laxmesh22/medha/hardware/renders/unit_waist_exploded.png

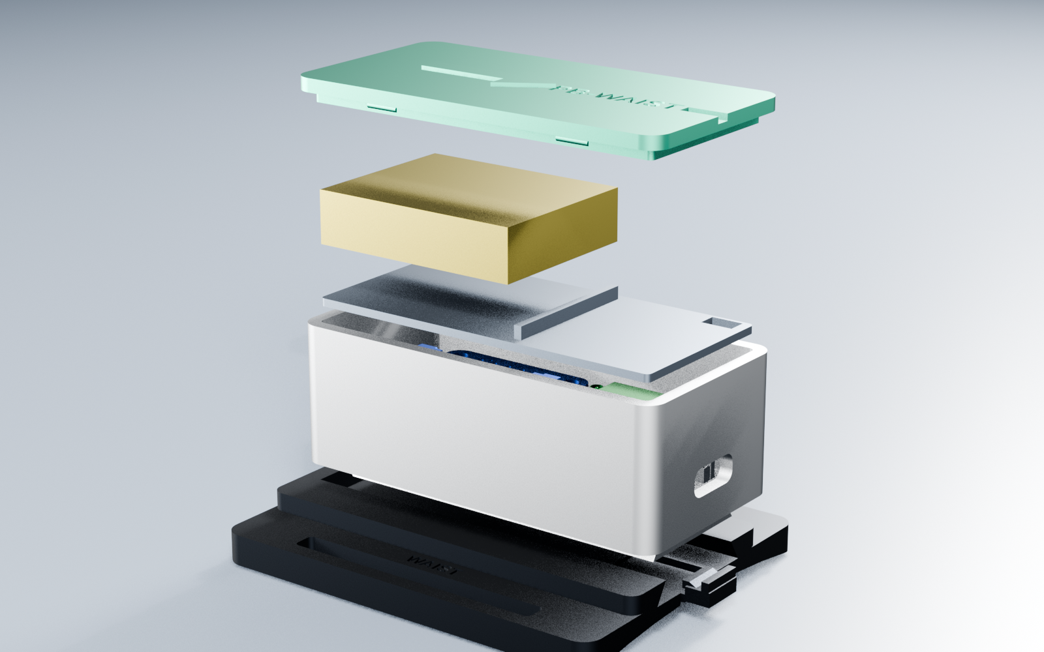
hardware/renders/unit_waist_exploded.png
