laxmesh22/medha/hardware/renders/unit_forearm_hero.png

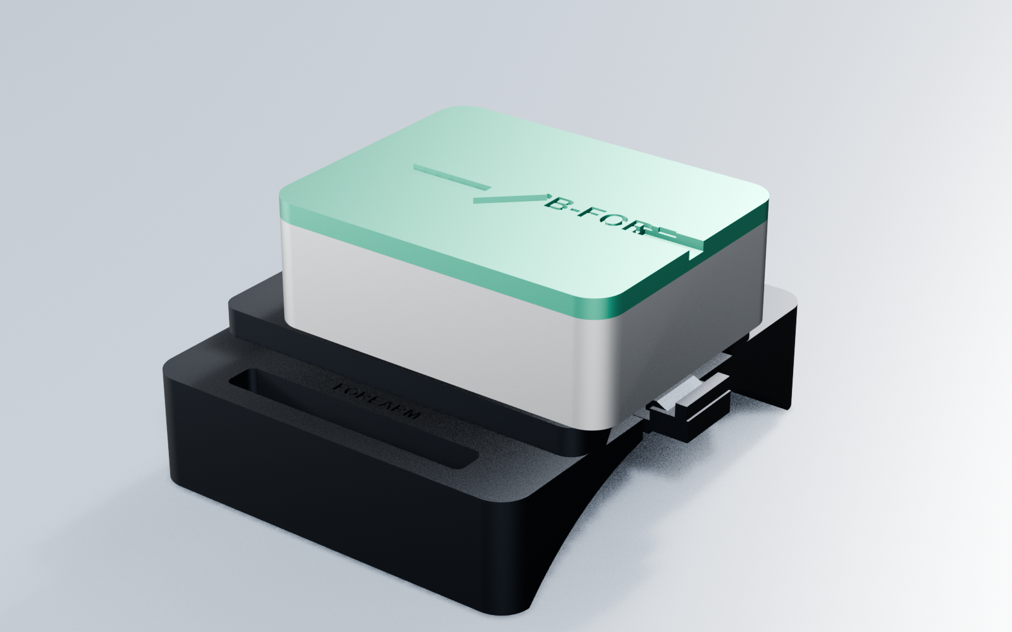
hardware/renders/unit_forearm_hero.png
