laxmesh22/medha/hardware/renders/frames_sheet.jpg

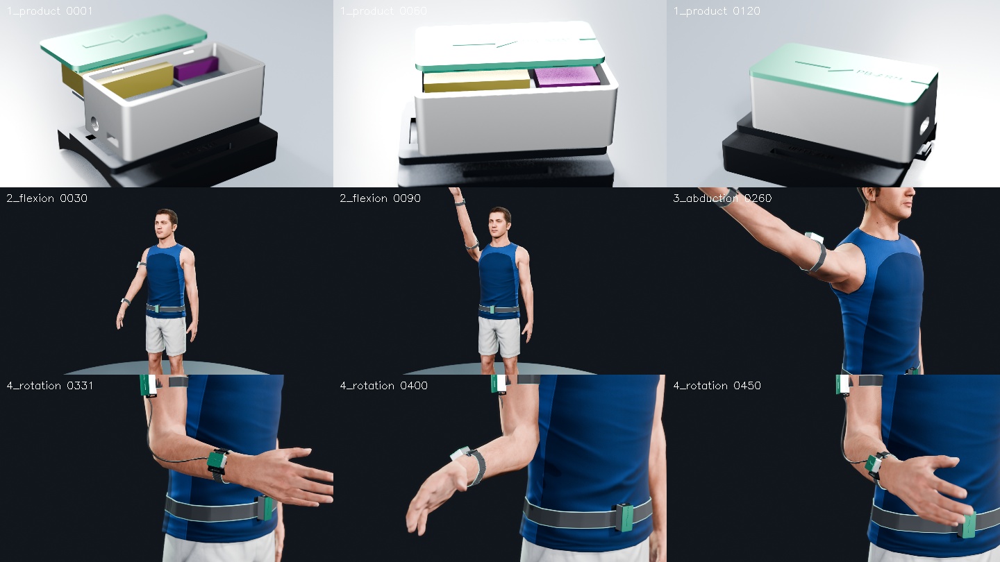
hardware/renders/frames_sheet.jpg
