laxmesh22/medha/hardware/renders/unit_chest_hero.png

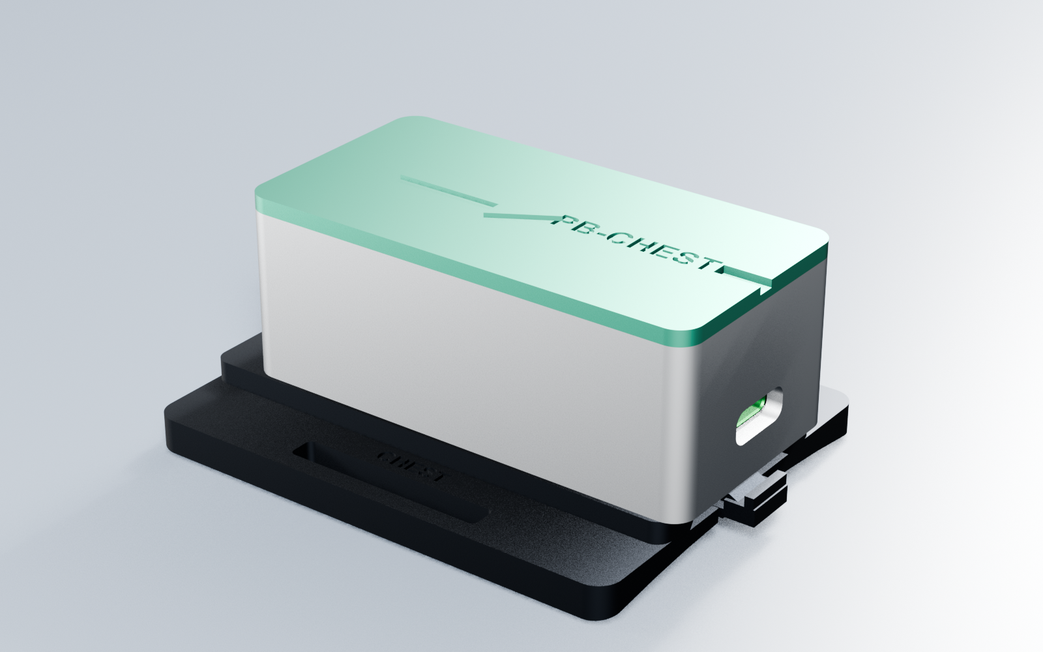
hardware/renders/unit_chest_hero.png
