laxmesh22/medha/hardware/renders/unit_forearm_exploded.png

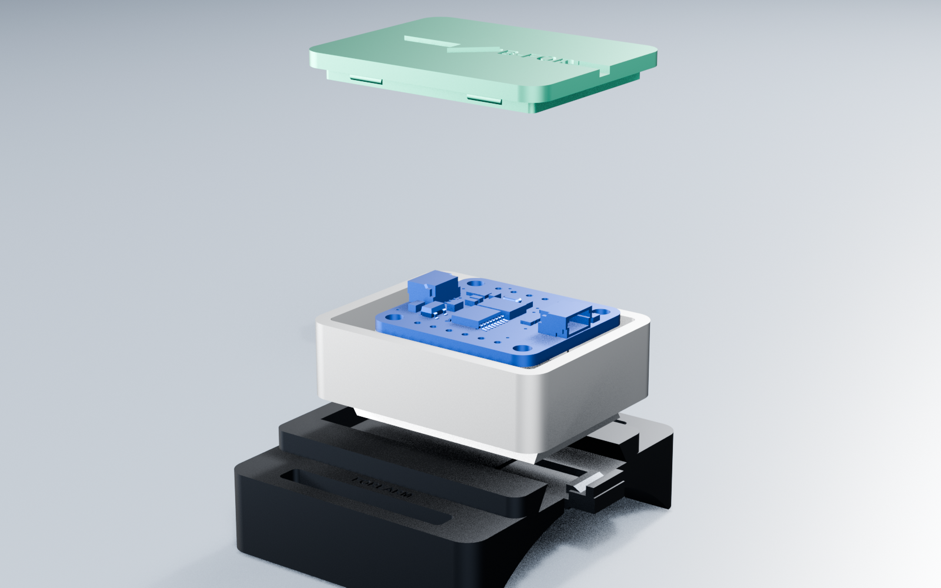
hardware/renders/unit_forearm_exploded.png
