laxmesh22/medha/hardware/renders/unit_upperarm_exploded.png

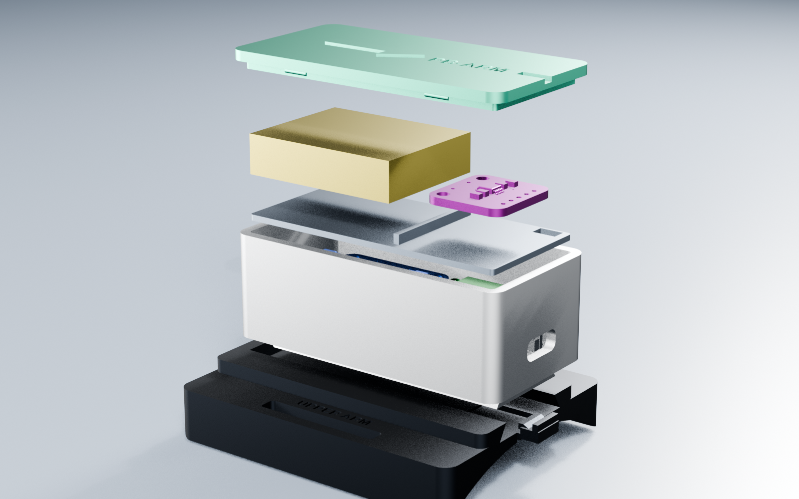
hardware/renders/unit_upperarm_exploded.png
