laxmesh22/medha/hardware/renders/unit_upperarm_hero.png

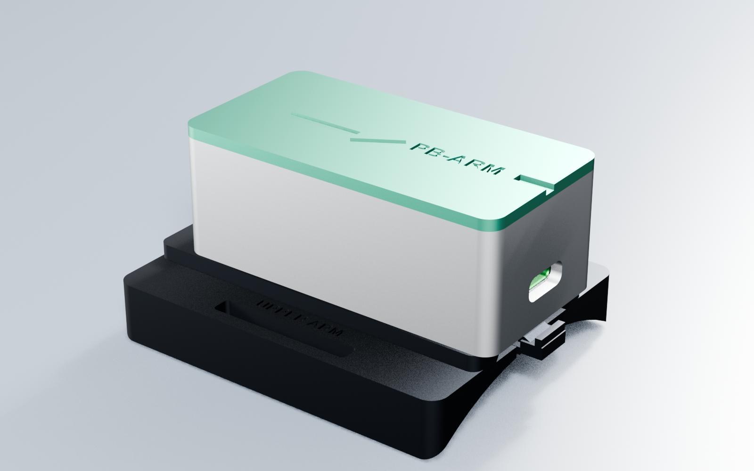
hardware/renders/unit_upperarm_hero.png
