laxmesh22/medha/hardware/cad/out/step/unit_upperarm.step

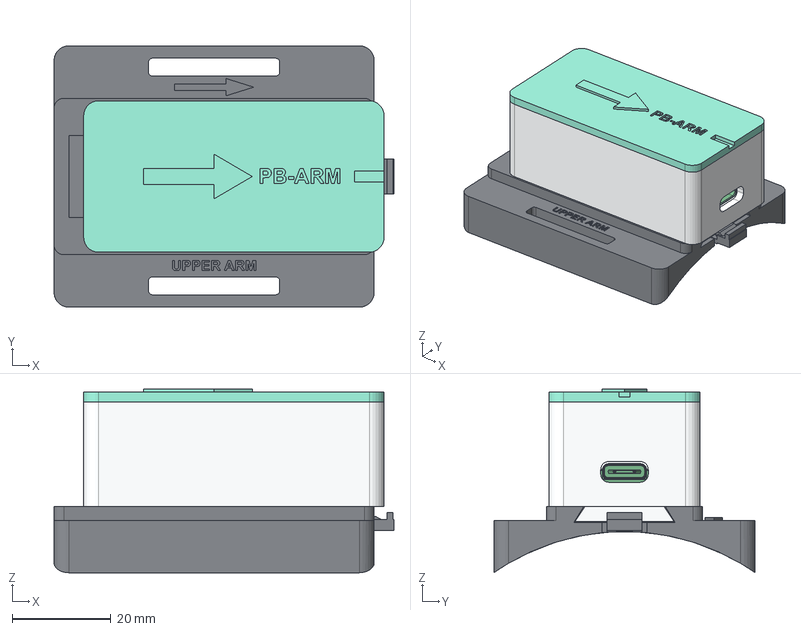
[picture p8: CAD file, 2026-10-26]
hardware/cad/out/step/unit_upperarm.step
68.7 x 52.8 x 37.1 mm
base
deck
lid
bno085
xiao
motor
switch
lipo
drv2605
