laxmesh22/medha/hardware/cad/out/step/base_forearm.step

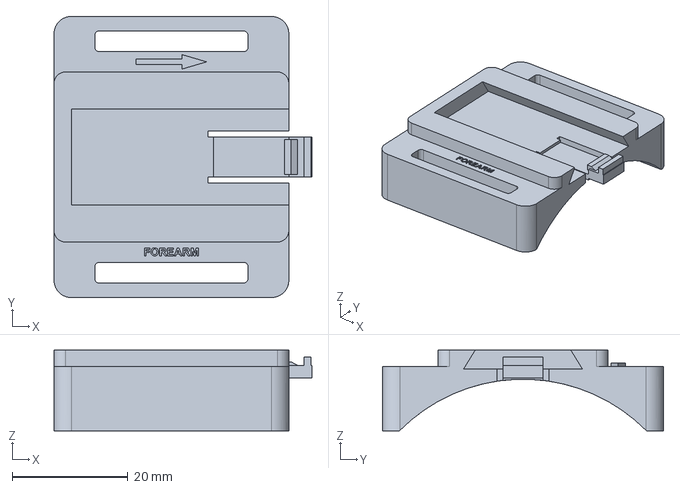
[picture p9: CAD file, 2026-10-26]
hardware/cad/out/step/base_forearm.step
44.6 x 48.6 x 14.0 mm
