laxmesh22/medha/hardware/cad/out/step/pod_arm_deck.step

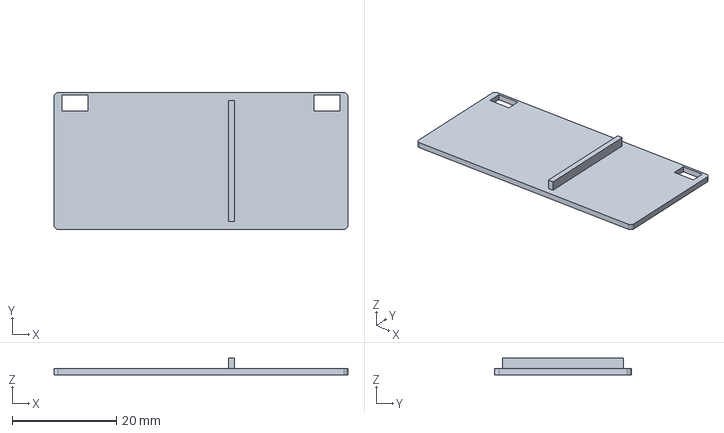
[picture p10: CAD file, 2026-10-26]
hardware/cad/out/step/pod_arm_deck.step
56.3 x 26.2 x 3.20 mm
