laxmesh22/medha/hardware/cad/out/step/pod_forearm_lid.step

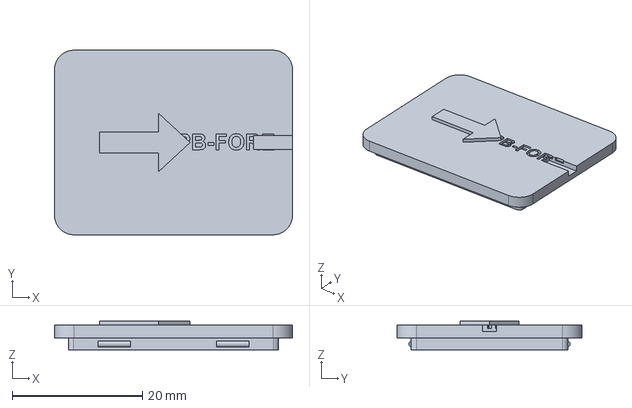
[picture p11: CAD file, 2026-10-26]
hardware/cad/out/step/pod_forearm_lid.step
36.6 x 28.4 x 4.40 mm
