laxmesh22/medha/hardware/cad/out/step/base_waist.step

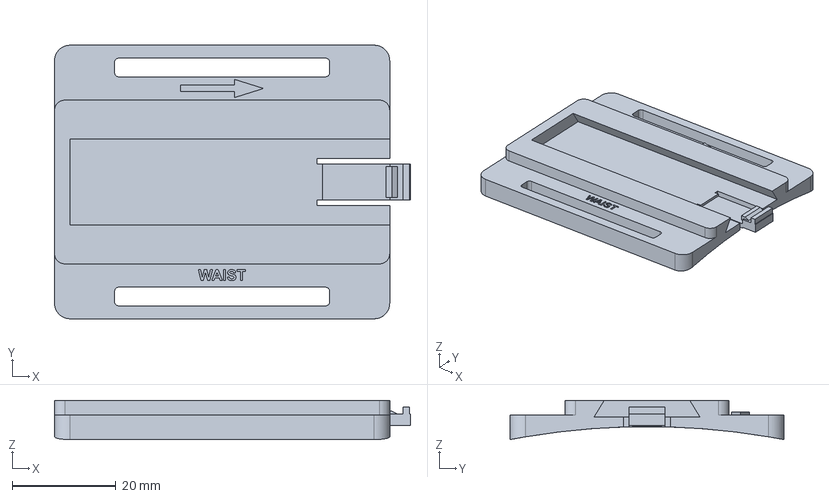
[picture p12: CAD file, 2026-10-26]
hardware/cad/out/step/base_waist.step
68.7 x 52.8 x 7.56 mm
