laxmesh22/medha/hardware/cad/out/step/base_upperarm.step

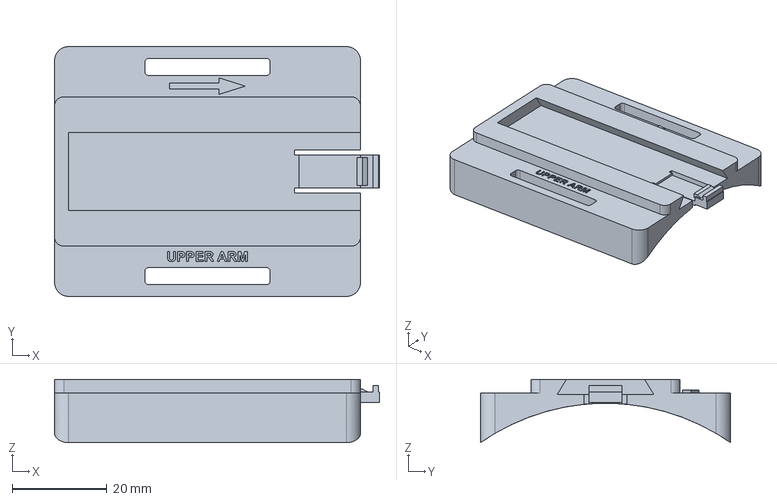
[picture p13: CAD file, 2026-10-26]
hardware/cad/out/step/base_upperarm.step
68.7 x 52.8 x 13.4 mm
