laxmesh22/medha/hardware/cad/out/step/pod_arm_body.step

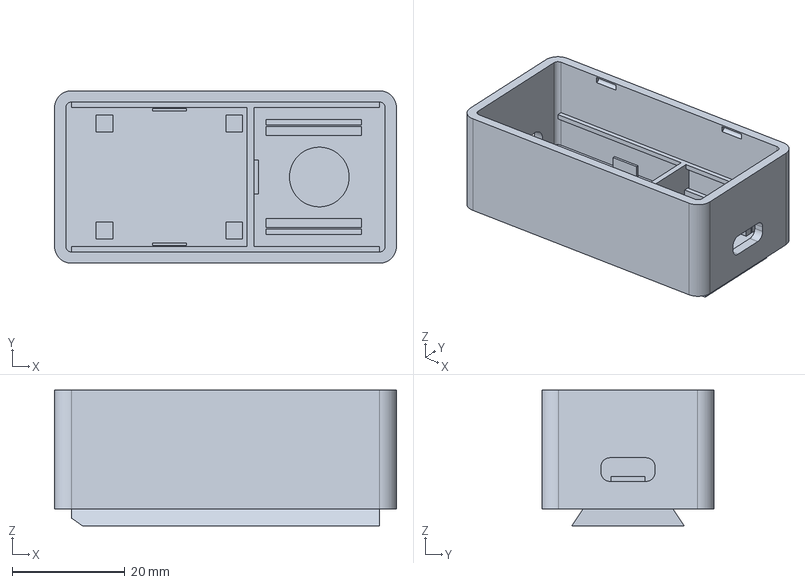
[picture p14: CAD file, 2026-10-26]
hardware/cad/out/step/pod_arm_body.step
60.7 x 30.6 x 24.1 mm
