laxmesh22/medha/hardware/cad/out/step/pod_waist_lid.step

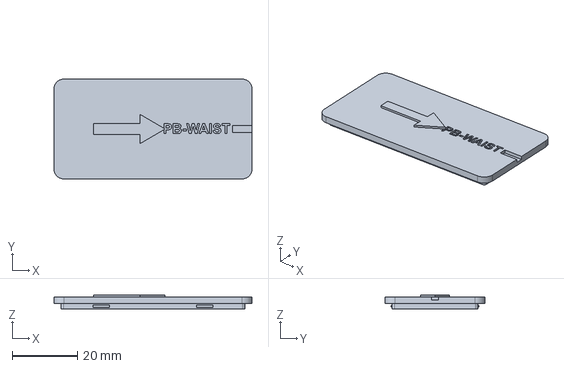
[picture p15: CAD file, 2026-10-26]
hardware/cad/out/step/pod_waist_lid.step
60.7 x 30.6 x 4.40 mm
