laxmesh22/medha/hardware/cad/out/step/unit_waist.step

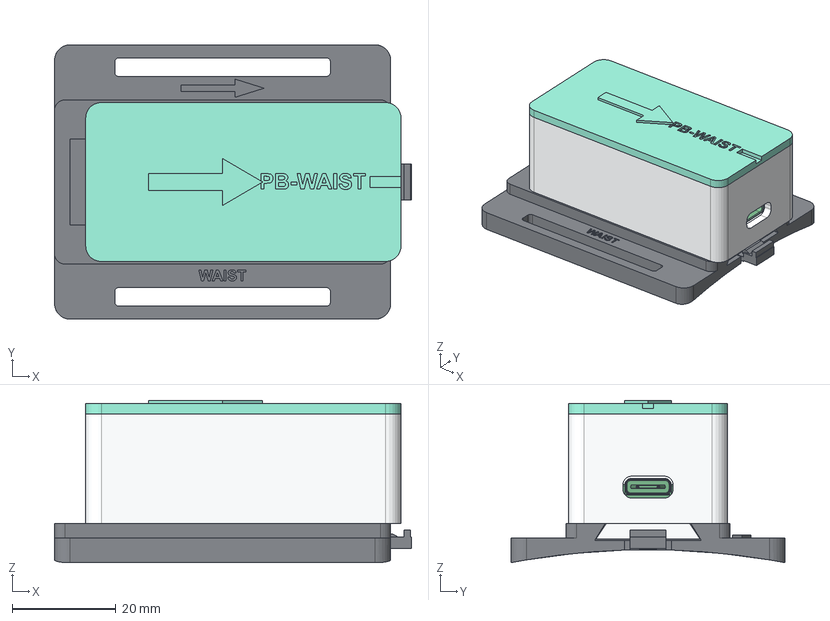
[picture p16: CAD file, 2026-10-26]
hardware/cad/out/step/unit_waist.step
68.7 x 52.8 x 31.3 mm
base
deck
lid
bno085
xiao
switch
lipo
