laxmesh22/medha/hardware/cad/out/step/pod_forearm_body.step

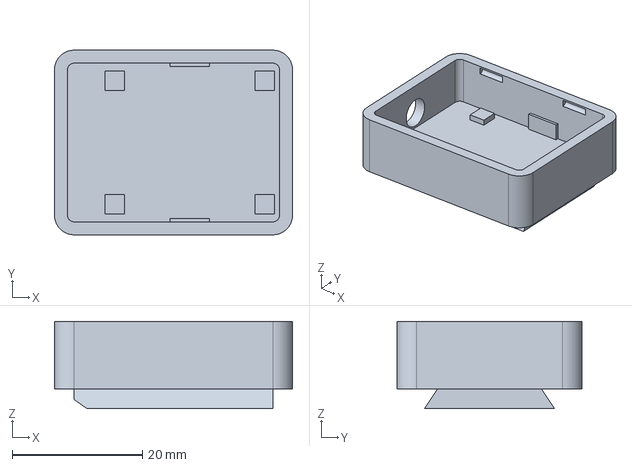
[picture p17: CAD file, 2026-10-26]
hardware/cad/out/step/pod_forearm_body.step
36.6 x 28.4 x 13.4 mm
