laxmesh22/medha/hardware/cad/out/step/unit_chest.step

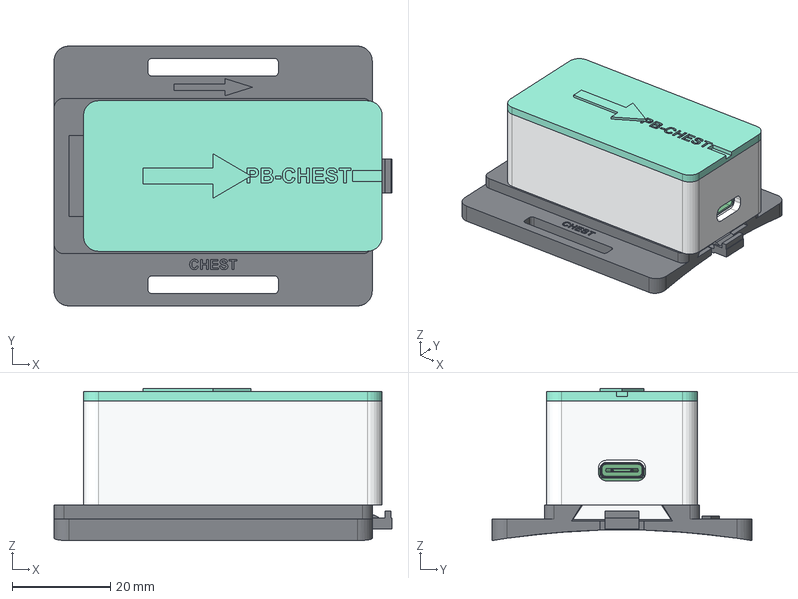
[picture p18: CAD file, 2026-10-26]
hardware/cad/out/step/unit_chest.step
68.7 x 52.8 x 30.9 mm
base
deck
lid
bno085
xiao
switch
lipo
