laxmesh22/medha/hardware/cad/out/step/unit_forearm.step

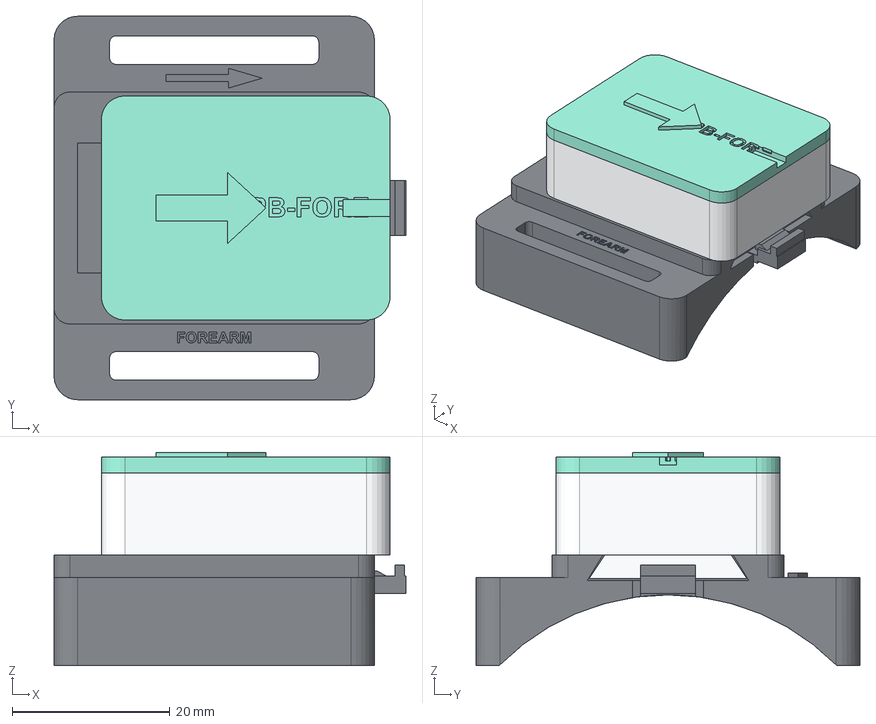
[picture p19: CAD file, 2026-10-26]
hardware/cad/out/step/unit_forearm.step
44.6 x 48.6 x 27.0 mm
base
lid
bno085
