laxmesh22/medha/hardware/cad/out/step/base_chest.step

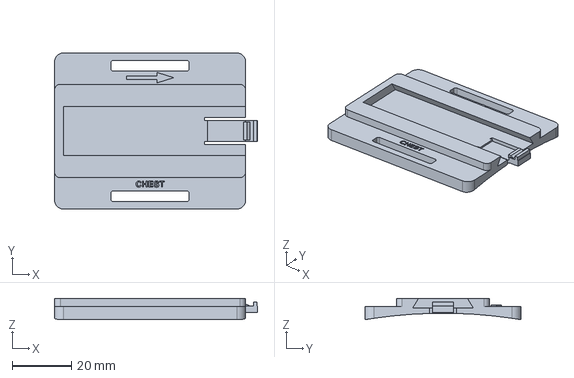
[picture p20: CAD file, 2026-10-26]
hardware/cad/out/step/base_chest.step
68.7 x 52.8 x 7.24 mm
