laxmesh22/medha/(list of files, cad)

Other CAD files:
hardware/cad/out/step/pod_arm_lid.step
hardware/cad/out/step/pod_chest_lid.step
hardware/cad/out/solidworks/base_chest.SLDPRT
hardware/cad/out/solidworks/base_forearm.SLDPRT
hardware/cad/out/solidworks/base_upperarm.SLDPRT
hardware/cad/out/solidworks/base_waist.SLDPRT
hardware/cad/out/solidworks/pod_arm_body.SLDPRT
hardware/cad/out/solidworks/pod_arm_deck.SLDPRT
hardware/cad/out/solidworks/pod_arm_lid.SLDPRT
hardware/cad/out/solidworks/pod_chest_lid.SLDPRT
hardware/cad/out/solidworks/pod_forearm_body.SLDPRT
hardware/cad/out/solidworks/pod_forearm_lid.SLDPRT
hardware/cad/out/solidworks/pod_waist_lid.SLDPRT
hardware/cad/out/stl/base_chest.stl
hardware/cad/out/stl/base_forearm.stl
hardware/cad/out/stl/base_upperarm.stl
hardware/cad/out/stl/base_waist.stl
hardware/cad/out/stl/pod_arm_body.stl
hardware/cad/out/stl/pod_arm_deck.stl
hardware/cad/out/stl/pod_arm_lid.stl
hardware/cad/out/stl/pod_chest_lid.stl
hardware/cad/out/stl/pod_forearm_body.stl
hardware/cad/out/stl/pod_forearm_lid.stl
hardware/cad/out/stl/pod_waist_lid.stl
