laxmesh22/medha/ml/reports/benchmark_20261014-2151.md

# Movement-judging benchmark (20261014-2151)

Sources: synthetic(4 subjects) - code-path check only. Protocol: GroupKFold(2) by subject (window 64 frames).

**Synthetic data: these numbers only check the code path.**

| Method | Accuracy | Macro-F1 | Unknown rejected | Form sens / spec | n |
|---|---|---|---|---|---|
| Rules only (geometry + thresholds) | 0.668 | 0.614 | 0.761 | 0.195 / 0.728 | 2795 |
| Lee 2024 MLP, IMU, random 80:20 | 0.800 | 0.789 | - | - / - | 72 |
| Lee 2024 MLP, IMU, LOSO | 0.694 | 0.680 | - | - / - | 72 |
| Random forest (Sassi-style), skeleton | 0.993 | 0.982 | 0.872 | - / - | 2795 |
| Random forest (Sassi-style), imu | 0.659 | 0.640 | 0.487 | - / - | 2795 |
| PB-MotionNet, skeleton | 0.312 | 0.235 | 0.547 | 0.000 / 1.000 | 2795 |
| PB-MotionNet, imu | 0.317 | 0.188 | 0.034 | 0.000 / 1.000 | 2795 |
| PB-MotionNet, fused | 0.356 | 0.281 | 0.504 | 0.000 / 1.000 | 2795 |

Angles in degrees always come from geometry (SkeletonKinematics); no method here outputs degrees.
