laxmesh22/medha/ml/reports/benchmark_20261014-2244.md

# Movement-judging benchmark (20261014-2244)

Sources: synthetic(4 subjects) - code-path check only. Protocol: GroupKFold(2) by subject (window 64 frames).

**Synthetic data: these numbers only check the code path.**

| Method | Accuracy | Macro-F1 | Unknown rejected | Form sens / spec | n |
|---|---|---|---|---|---|
| Rules only (geometry + thresholds) | 0.668 | 0.614 | 0.761 | 0.195 / 0.728 | 2795 |
| Lee 2024 MLP, IMU, random 80:20 | 0.800 | 0.789 | - | - / - | 72 |
| Lee 2024 MLP, IMU, LOSO | 0.694 | 0.680 | - | - / - | 72 |
| Random forest (Sassi-style), skeleton | 0.993 | 0.982 | 0.872 | - / - | 2795 |
| Random forest (Sassi-style), imu | 0.725 | 0.718 | 0.581 | - / - | 2795 |
| PB-MotionNet, skeleton | 0.189 | 0.100 | 0.000 | 0.000 / 1.000 | 2795 |
| PB-MotionNet, imu | 0.173 | 0.059 | 0.060 | 0.000 / 1.000 | 2795 |
| PB-MotionNet, fused | 0.202 | 0.110 | 0.086 | 0.000 / 1.000 | 2795 |

Scored on original windows of held-out subjects only (augmented copies are training data). PB-MotionNet's unknown cutoff is tuned on held-out calibration subjects.
Angles in degrees always come from geometry (SkeletonKinematics); no method here outputs degrees.

## Limitations

- Skeleton branch has never seen a RealSense + RTMPose skeleton (public Kinect / motion-capture only). Results do not describe the Clinic Station until validated on team recordings.
- Camera + strap together was not measured on real people: no source records both. Needs team recordings with the straps worn.
- Strap branch trained only on a wrist-worn Apple Watch (SPAR). It does not transfer to BNO085 straps on the arm, forearm and chest; the hub ignores strap input until validated.
