laxmesh22/medha/(commit log)

2026-10-14 Baseline: Physio Buddy clinic station, coach, anatomy and ML pipeline
    First commit, so concurrent agents have a reference point to diff against.
    - hub: RealSense/RTMPose camera pipeline, depth lift, shoulder kinematics,
    rule coach with per-rep verdicts and safety pause, guided dataset recorder,
    advisory-only PB-MotionNet inference, FastAPI/WebSocket server, simulator
    - web: station UI with Rocketbox patients, Z-Anatomy X-ray view, voice coach,
    vision overlay, recording drawer
    - ml: public dataset loaders (SPAR, IntelliRehabDS, REHAB24-6), Lee 2024
    baseline, PB-MotionNet training with subject-grouped evaluation,
    validate_real gate, benchmark
    - calibration guard: never hold out cali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
2026-10-14 Add AGENTS.md coordination notes and LF line-ending policy
    Two agents edit this repo concurrently. AGENTS.md records working rules,
    proposed file ownership, what changed after the other agent's last edit
    (calibration guard) and open items for it.
2026-10-26 Add CAD inspection tools and log the radio-clip review
    tools/cad: STL report (size, bodies, watertightness, volume, PLA weight),
    Blender multi-view renderer with a 10 mm grid, and a scaled cross-section
    plotter. Used to review the supplied Cobra radio clip STL.
2026-10-26 Add wearable pod CAD: parametric parts, fit check, STEP/STL/GLB/SolidWorks outputs
    hardware/cad/physio_pod.py (CadQuery/OpenCascade) builds the upper-arm pod
    (BNO085, XIAO ESP32-S3, coin motor, switch; LiPo + DRV2605L on a deck), the
    forearm pod (BNO085), snap lids with orientation arrows and labels, and curved
    strap bases (upper arm, forearm, chest, 40 mm waist belt) sharing one dovetail
    quick-release rail with a click latch.
    The build checks that every component clears its bay and every pod seats in
    every base, and all 13 STL parts are watertight single bodies. Vendor STEP
    models dropped into hardware/cad/vendor/ replace the stand-in blocks.
    tools/cad/solidworks_convert.py saves native SL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
2026-10-26 Add on-body device video: avatar wearing the pods, waist belt, captions
    tools/blender/device_on_avatar.py renders the Rocketbox avatar wearing the upper-arm,
    forearm and waist units through flexion, abduction and external rotation, plus a
    product explode/assemble shot, and edits them into hardware/renders/physio_buddy_device.mp4.
    Log the CAD and video work in AGENTS.md.
2026-10-26 CAD: check fit against real BNO085, XIAO ESP32-S3 and DRV2605L models
    Vendor STEP models (Adafruit 4754 BNO085 and 2305 DRV2605L from Adafruit_CAD_Parts,
    Seeed XIAO ESP32-S3 from GrabCAD) now drive the collision check. Y-up models are laid
    flat on import. The XIAO is 4.5 mm tall, not 3.6, so the arm pod grows 0.9 mm
    (60.7 x 30.6 x 23.1 mm). The SS-12D00 model is not imported: its lever and pins pass
    through the wall slot by design. Vendor STEPs are git-ignored; the vendor README has
    the download commands. Product renders regenerated.
2026-10-26 Regenerate SolidWorks parts for the 23.1 mm arm pod; log vendor-model fit check
2026-10-26 AGENTS.md: Claude working on device video v2
2026-10-26 Device film v2: Blender shot script, synthesized soundtrack, Remotion edit
    tools/blender/device_film.py renders clean shots (studio sweep, Cycles on the RTX GPU with
    the OptiX denoiser) and exports per-frame callout positions and skeleton-measured arm
    angles. tools/audio/make_soundtrack.py synthesizes a 120 BPM track timed to the edit plus
    whoosh/click/tick effects. video/ is a Remotion project: tracked callouts, a live angle
    HUD, transitions and the soundtrack.
2026-10-26 Device film v2: final render, overlay layout fixes, tracking data
    hardware/renders/physio_buddy_film_v2.mp4: 35 s, 1080p, synthesized soundtrack.
    Angle HUD moves to the side the arm does not swing through; callouts kept inside the
    frame; product title clears before the exploded-view callouts. The encoder handles shots
    that keep their timeline frame numbers, and device_film.py can re-render part of a shot.
    Per-frame tracking JSON committed (the edit imports it). AGENTS.md logged.
2026-10-26 AGENTS.md: Claude working on the assembly guide video
2026-10-26 Assembly guide video: CAD-accurate Blender steps, Remotion step panels and wiring diagram
    tools/blender/assembly_guide.py renders one clip per build step (kit, neoprene, BNO085 on
    foam pads, motor, switch, XIAO on rails, wiring, deck, LiPo + DRV2605L, lid snap, forearm,
    waist, strap threading, charging, power) with callout tracking. video/src/guide/ adds the
    AssemblyGuide composition: instruction panel per step, progress bar, animated wiring diagram
    (agenthandoff.md section 6), kit tags, callouts that stay out of the panel. The soundtrack
    script gains --guide (calm bed + step chime). Final render in hardware/renders/.
2026-10-26 Strap features v2: device-layout strap geometry, calibration, virtual straps
    The strap branch was trained on a single wrist IMU, but the device has BNO085s on the
    upper arm, forearm and waist. core/strap_kin.py computes the same clinical angles and
    compensation flags as the camera from strap quaternions, with N-pose + forward-raise
    calibration. Features v2 replace raw wrist/arm/chest acc+gyro with strap kinematics,
    per-strap rate and gravity, and present flags (D_IN 56 -> 68; old models refused).
    pbml/straps.py drives imperfectly worn, really-calibrated virtual straps from synthetic
    and augmented skeletons. Synthetic diagnostic: strap accuracy 0.68 -> 0.93, faulty-rep
    sensitivity 0.20 -> 0.6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
2026-10-28 Clinician dashboard: referral-code linking, patients, versioned care plans, progress
    New clinician/ app (Vite + React + TypeScript + Supabase). The physio onboards and gets a
    unique referral code; patients link with it from the patient app and consent to share.
    Pages: overview with alerts, patients list, patient detail (range-of-motion charts against
    clinician targets, adherence, pain, form flags; care-plan editor with version history;
    sessions; medical info), profile with referral code + QR, exercise library. Runs on demo
    data without Supabase keys. supabase/schema.sql is the shared schema with row-level
    security and RPCs; README documents the data contract for the patient app.
    Co-Authored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
2026-10-28 Clinician dashboard: video consults, phone layout, shareable preview build
    Each patient-clinician link gets a private video room (care_links.video_room) and calls are
    booked, started and listed in video_calls (schema + row-level security). Calls open on Jitsi
    Meet in a new tab (provider configurable via VITE_VIDEO_BASE_URL); the patient page gains a
    Video calls tab and header call button, the overview lists booked consults. Phone-width
    navigation and layout. npm run artifact packs a single-page demo build (memory router, demo
    data) for sharing.
2026-10-28 Clinician dashboard: Auth0 + Google sign-in and new doctor sign-up
    Sign-in runs on Auth0 (Google connection, email via the hosted page) when configured,
    otherwise Supabase auth; the demo simulates both. New /signup page: account, professional
    details (qualification, specialisation, clinic, city, council, registration number,
    experience, phone), declarations, then the referral code. Schema identifies people by the
    token subject (current_sub) so Auth0 users work with row-level security; clinicians gain
    professional fields and a verification status. Video room links carry a meeting subject.
    README documents the Auth0 setup (post-login Action adding role=authenticated to the ID
    token, Supabase t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
2026-10-28 Clinician dashboard: rename the device to Auri
    Brand name, demo clinic, referral-code prefix (AU-), video room prefix and consult subject now say Auri.
    The sign-in brand panel no longer mentions the clinic station.
2026-10-28 Auri dashboard intro video (Remotion AuriIntro)
    54 s walkthrough of the clinician dashboard: Google sign-up, referral code, overview, patients, range-of-motion
    charts, versioned care plan and video consult. Screens captured from the demo build by
    video/scripts/capture_dashboard.mjs; music from make_soundtrack.py --intro. Output
    hardware/renders/auri_dashboard_intro.mp4.
2026-10-29 Showcase script (docs/SHOWCASE.md) and summary card labels
    Stand guide for 31 Oct built from what the code does (flags checked with --help): set-up, five-minute walk-through,
    what to say honestly, fallbacks. Summary card now says 'Best angle' and 'Since your pain check at ...'.
    Done by the Cursor agent (brief 004); Claude switched the dashboard step to the forced demo mode.
2026-10-29 Strap firmware v0.1: BLE protocol v1, XIAO C3/S3 sketch, probe and host BLE test
    firmware/protocol: PROTOCOL.md (fixed UUIDs, 17-byte IMU and 20-byte gyro+gravity packets, commands incl. time
    ping, status record) and auri_ble.py decoder. firmware/auri_strap: NimBLE server, BNO085 game rotation vector,
    200 ms silence -> valid=0 + recovery, never fabricated samples, optional haptics/battery, pins per chip.
    Tested on the bench XIAO ESP32-C3 (bare, no sensors): link test 50/100 Hz with 0 seq gaps, commands, RTT 19 ms.
    Built and tested by the Cursor agent from Claude's design and code.
2026-10-29 Strap firmware: own multi-instance BNO08x driver (two sensors per MCU)
    SparkFun/Adafruit BNO08x keep one global CEVA SH-2 session (sh2.c:323, shtp.c:148 MAX_INSTANCES 1), so the arm
    pod's two BNO085s (0x4A + 0x4B) cannot share an MCU. bno_lite: per-object SHTP transport, soft reset, product ID,
    Set Feature, chunked reads with continuation-header checks, game RV / gyro / gravity parsing. Desk-checked by the
    Cursor agent against the CEVA sources; builds for C3 and S3; BLE link test unchanged (50/101 Hz, 0 gaps).
    Not yet run against a real BNO085.
2026-10-29 Strap firmware: first real BNO085 run, bench pin override, pin finder
    Bench C3 has the STEMMA wires on D5/D6 (pinscan found SDA GPIO7, SCL GPIO21, 0x4A): AURI_PIN_SDA/SCL override,
    boot line prints the I2C pins. bno_lite on real hardware: part 10004148 sw 3.2.13; 50 Hz for 30 s: 1500 packets,
    0 gaps, 100% valid, |q| = 1.0000, |g| = 9.78 m/s^2. Known: 100 Hz drops ~5% and a later write failed with
    Insufficient Resource (two notifies per sample); the IMU reset blocks loop() ~600 ms. ble_probe prints norms and
    an accuracy histogram. Tested by the Cursor agent.
2026-10-29 docs: connect the Flutter patient app to the shared Supabase + Auth0
    Native Auth0 app, auth0_flutter + supabase_flutter with Auth0's ID token as Supabase's accessToken, and the
    patient-side data flow (profile, referral-code link, plan, sessions, video calls) checked against schema.sql.
2026-10-29 Strap firmware: protocol v2 (combined 37-byte packets), non-blocking IMU reset, boot window; verified on hardware
    Board 2 (XIAO C3 + BNO085, spec pins D4/D5, 400 kHz): 3 resets all detected, i2c_errors 0; BLE 30 s at 50 Hz
    1500/1500 and 30 s at 100 Hz 3000/3000 packets, 0 seq gaps, notify_drops 0, |q| = 1.0000, |g| = 9.80 m/s^2;
    IMU reset recovers in 368 ms with STATUS still flowing. Fixes: onConnect reads the MTU Windows already
    negotiated (combined packets were off), 0.5 s re-detect for the first 5 s, NACKs during the 400 ms after a reset
    are not I2C errors, product-ID retry. Board 1's silent sensor is a hardware fault (same firmware works on board 2).
    Built and tested by the Cursor agent;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
2026-10-29 Hub: receive Auri straps over BLE (step A1)
    hub/physiobuddy_hub/straps: protocol decoder (moved from firmware/protocol, which now re-exports it) and StrapLink
    (bleak in its own thread, reconnect with backoff, time pings, lower-envelope clock offset, 200 ms staleness ->
    unavailable, per-device rate/gaps/drops/i2c errors). run --straps off|auto|ADDR (default off; bleak optional extra).
    /api/status and /ws/live carry a straps block; nothing reaches the coach yet. 125 tests pass; live: board 2 at
    ~50 Hz, 0 gaps, upper_arm available, offset stable. Built by the Cursor agent from Claude's design.
2026-10-29 Hub: strap calibration, strap angles, network input and station Straps card (step A2)
    POST /api/straps/calibrate/npose (2 s still, rejects motion) and /raise (forward-raise refinement), GET calibration;
    resets on side change or reconnect. Per frame: StrapKinematics angles and the imu_features block passed to
    MotionNet (imu=None when uncalibrated); the coach still counts from the camera. Station UI shows camera vs strap
    degrees, 'unavailable' when missing (true elevation needs the trunk strap). 129 tests pass; live: N-pose accepted
    (87 samples), strap apparent elevation stable to 0.08 deg over 10 s. Built by the Cursor agent from Claude's design.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
2026-10-29 AGENTS.md: strap firmware + hub ingest log, recorder request for Codex
2026-10-29 Station: AURI-CV webcam mode, two straps by address, BLE on its own thread, camera preview, 30 fps capture, dashboard colour scheme (bridge 021-032)
2026-10-29 docs: device + CV handoff, video/tools method, full Flutter guide; low-token bridge watcher
2026-10-29 Keep the webcam bright without dropping below 18 fps.
    Auto exposure is kept when it is fast enough; otherwise the brightest manual setting that still reads quickly is used, and the camera preview fetches from the page origin.
2026-10-30 Let the phone forward the worn strap pose to the station.
    The three bands stay on the phone. The station locks the position they are worn in and poses the figure from that, so Claude can continue from the 31 Oct handoff.
2026-10-30 Mirror the strap pose onto the other arm, like the camera keypoints.
    In mirror mode x was flipped but the patient's own arm bone was still posed,
    so side raises crossed the chest and the ROM arc sat on the other arm.
2026-10-30 Calibrate the waist strap's forward from a forward lean.
    The N-pose sets only up on the waist box, so worn on the back or side a
    forward lean read backward or sideways, on the figure and in trunk lean.
2026-10-30 Say which band is misplaced during calibration; keep the strap figure a rotation.
    - Raise and lean now refuse to save when a band did not move with its segment
    (upper arm still while the forearm moved, waist moving in an arm raise,
    waist not tipping in a lean), and name the band.
    - Undo a front/back-only flip in strap_pose: it mirrored the figure. A raise
    drawing backward came from an upper-arm band the raise never set.
    - Tests use a scratch worn-position file instead of the station's own.
    - From a concurrent agent edit: the saved worn position is no longer dropped
    on the first phone sample.
2026-10-30 AGENTS log: band placement check, flip undone, upper-arm reconnect.
2026-10-30 Phone strap status: each band's turning speed and last seq.
    Shows which band is the one being moved, so a band in the wrong slot is
    obvious (it is how the swapped forearm and upper-arm bands were found).
2026-10-30 AGENTS log: arm bands swapped in the app.
2026-10-30 Drop strap calibration when a band's sensor reboots; add a camera-vs-strap check.
    A BNO085 that reboots restarts its game rotation vector with a new yaw
    reference, so the saved calibration turns the figure the wrong way without any
    sign. The phone now forwards the firmware's reset bit, and a reset starts a new
    generation, which drops the calibration. Status counts resets per band.
    tools/compare_straps_camera.py pairs the camera skeleton with the strap
    directions live and reports elevation, heading and mirror/flip errors.
2026-10-30 Webcam: keep a slow auto picture over a fast black one in a dim room.
    At 04:08 auto exposure gave a usable colour frame at 10 fps, the fast manual
    exposures were black, and the brightness lift turned black into flat grey
    (spread 1.7), so the detector saw no person. Now auto is kept when every fast
    exposure is too dark to hold a person.
2026-10-30 Calibrate the forearm against the upper arm during the straight-arm raise.
    Live held poses with a straight elbow read 28-46 deg elbow bend: the forearm
    pointed 35-50 deg away from the upper arm. The N-pose takes the forearm's long
    axis from gravity, so a forearm not hanging straight then leaves it tilted, and
    wrist twist swings the error around. With the elbow straight the forearm
    follows the upper arm through the whole raise, which fixes its long axis and
    forward together (refused when the fit is worse than 12 deg).
    tools/strap_pose_test.py checks held poses against gravity, no camera needed.
2026-10-30 Station page: say how well the forearm matched the arm in the raise.
2026-10-30 Elbow angle from the two arm straps without the waist; fix the two stale tests.
    The elbow is the angle between the upper-arm and forearm straps, so it no
    longer waits for the waist strap (rotation still does). The two tests that
    expected no straps block now check the always-shown phone slots invent
    nothing when no phone data arrives. 165 passed.
2026-10-30 docs: strap calibration guide.
2026-10-30 Keep the strap calibration across a sensor reboot.
    Live: the wrist band's BNO085 went silent and rebooted 3 times while its BLE
    link stayed up; each reboot dropped the calibration and froze the figure. The
    yaw step at a reboot is now taken out using the last good sample (the limb has
    not moved in that moment), so the calibration holds. A reboot with no recent
    sample still drops it. Status counts reanchors per band.
2026-10-30 Side-raise calibration step.
    The side raise sets sideways the way the forward raise sets forward. After a
    forward raise the two are split evenly, so one crooked raise counts for half.
    A side raise to the other side means the bands are on the other arm: nothing
    is changed and the page says to switch Left/Right. Guided calibration runs it
    after the forward raise; it also has its own button. 169 passed.
2026-10-31 Voice coach on camera + band data, with DeepSeek/Claude answers and Sarvam voice.
    - Coach fusion (handoff 9.4): the camera is the measurement and the bands
    check it; a >20 deg disagreement is not counted and the coach asks for a slow
    repeat (never averaged). Band-only counting when the camera loses the arm is
    an operator switch, off by default (not validated). Bands add a bent-elbow
    cue for straight-arm raises and waist-measured trunk lean.
    - Free questions go to Claude when a Claude credential exists, else DeepSeek,
    with the station's own measured session as the only facts; safety rules:
    no diagnosis, no prescription changes, no invented numbers. Pain and stop
    stay rule-based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
2026-10-31 Restore the patient-tables migration (it held the SQL editor's warning text).
    Rebuilt from schema.sql. Live Supabase was checked read-only with the anon key:
    patient_intake, patient_consents and patient_settings exist and refuse
    anonymous reads; 038's columns and preview_clinician_by_code exist. Nothing
    needed applying.
2026-10-31 Station: full-screen guided calibration with a demo figure and the live figure.
    Guided calibration opens an overlay: step title, one plain instruction and a
    big countdown in large type, a 'Do this' figure that acts out the step next to
    the 'You' figure driven by the bands, a hold-still warning from the bands'
    turning speed, and a clear tick or reason per step with Try again. Both figures
    are mirrored like the main view. The overlay's 3D stage stops drawing when
    closed.
2026-10-31 Supabase: only the patient's referral code grants a doctor access.
    - care_links: either side can only end a link (status = 'ended'). Before, the
    update policy let a doctor re-activate a link the patient had ended, or move
    it to another patient. Re-activation now needs the patient to enter the code
    again. Only the status column is updatable.
    - clinicians: a doctor can edit their details but not verification_status or
    referral_code (column grants).
    - A patient sees the doctor's row only while the link is active.
    The dashboard and app only read these tables and change them through
    security-definer functions, so nothing breaks. Not yet run on live.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
2026-10-31 Supabase: only verified doctors can be linked to patients or see their data.
    link_patient_with_code and preview_clinician_by_code refuse a doctor whose
    verification_status is not 'verified' ('clinician not verified'), and
    is_linked_clinician now also needs the doctor to be verified, so every
    patient-data policy and publish_care_plan stop at once for a rejected doctor.
    Not yet run on live; doctors must be verified first.
